BleuLlama/AmigaInputToUSB/Images/0703_Parts.png

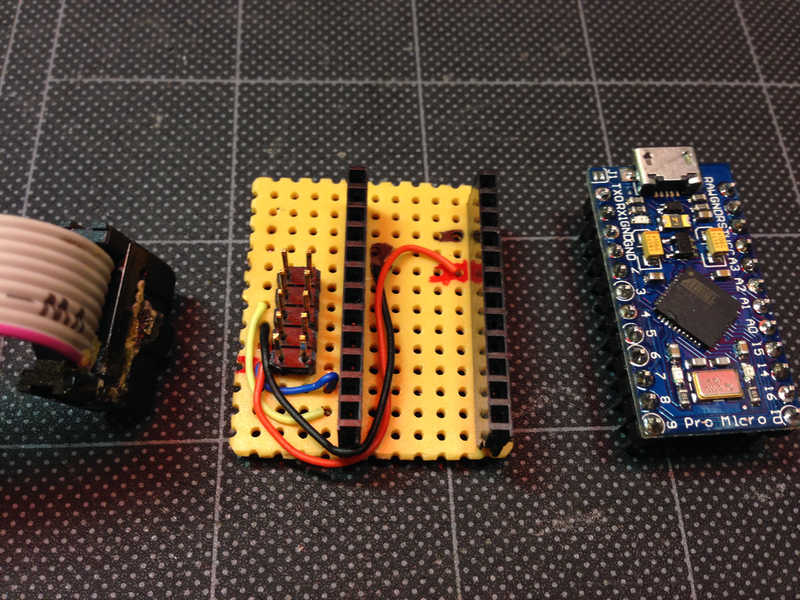
Images/0703_Parts.png
