BleuLlama/AmigaInputToUSB/Images/0703_AmigaMouse.png

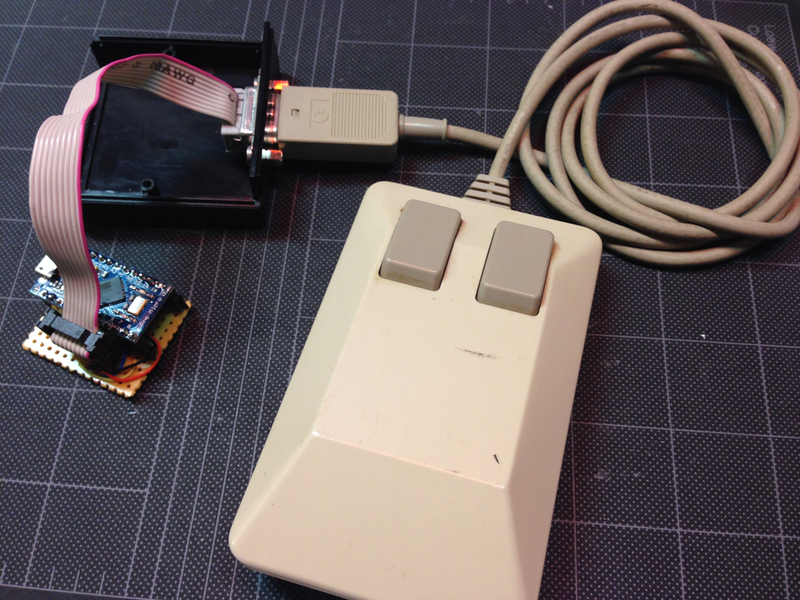
Images/0703_AmigaMouse.png
