BleuLlama/AmigaInputToUSB/Images/0703_Box.png

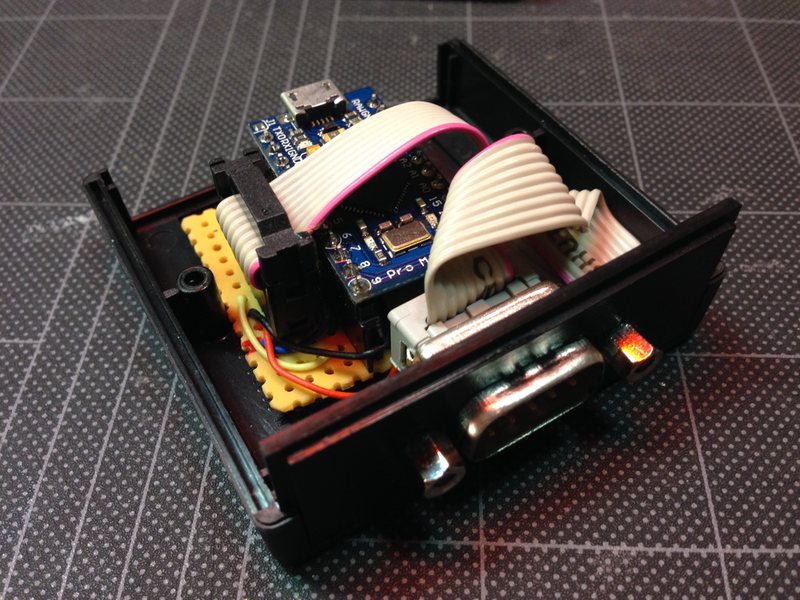
Images/0703_Box.png
