BleuLlama/AmigaInputToUSB/Images/0703_Joystick.png

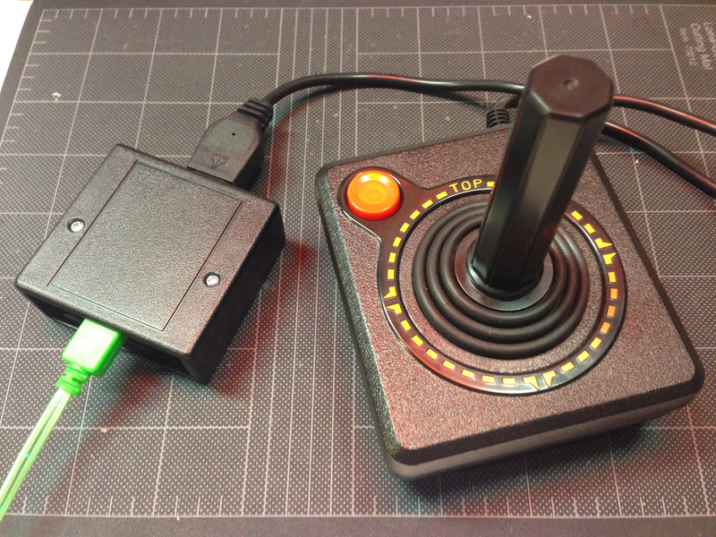
Images/0703_Joystick.png
