BleuLlama/AmigaInputToUSB/Images/Amiga_to_ST_converters.png

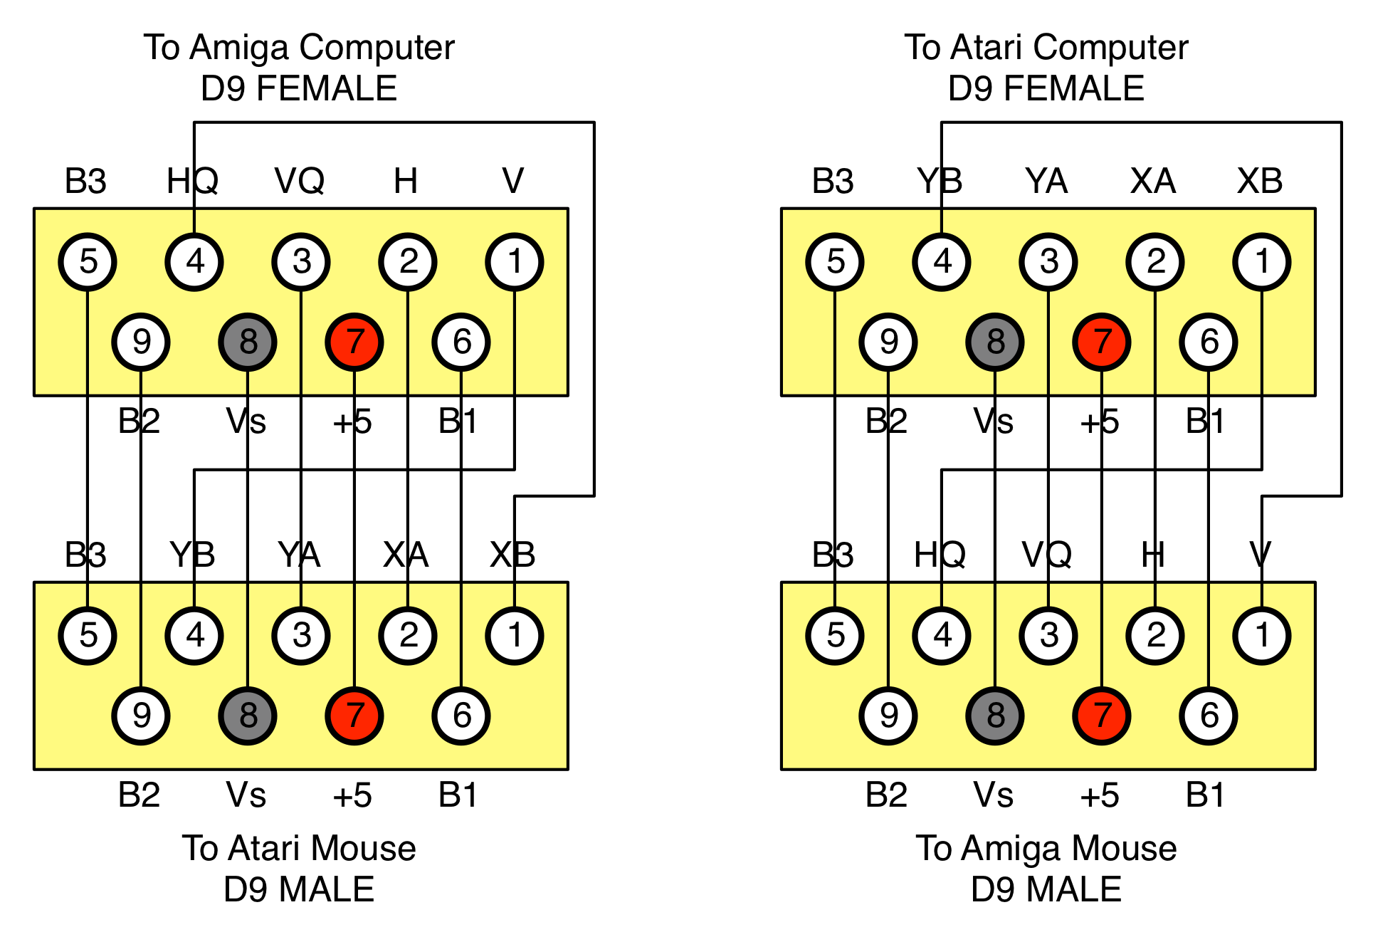
Images/Amiga_to_ST_converters.png
