BleuLlama/AmigaInputToUSB/Images/D9_pinouts.png

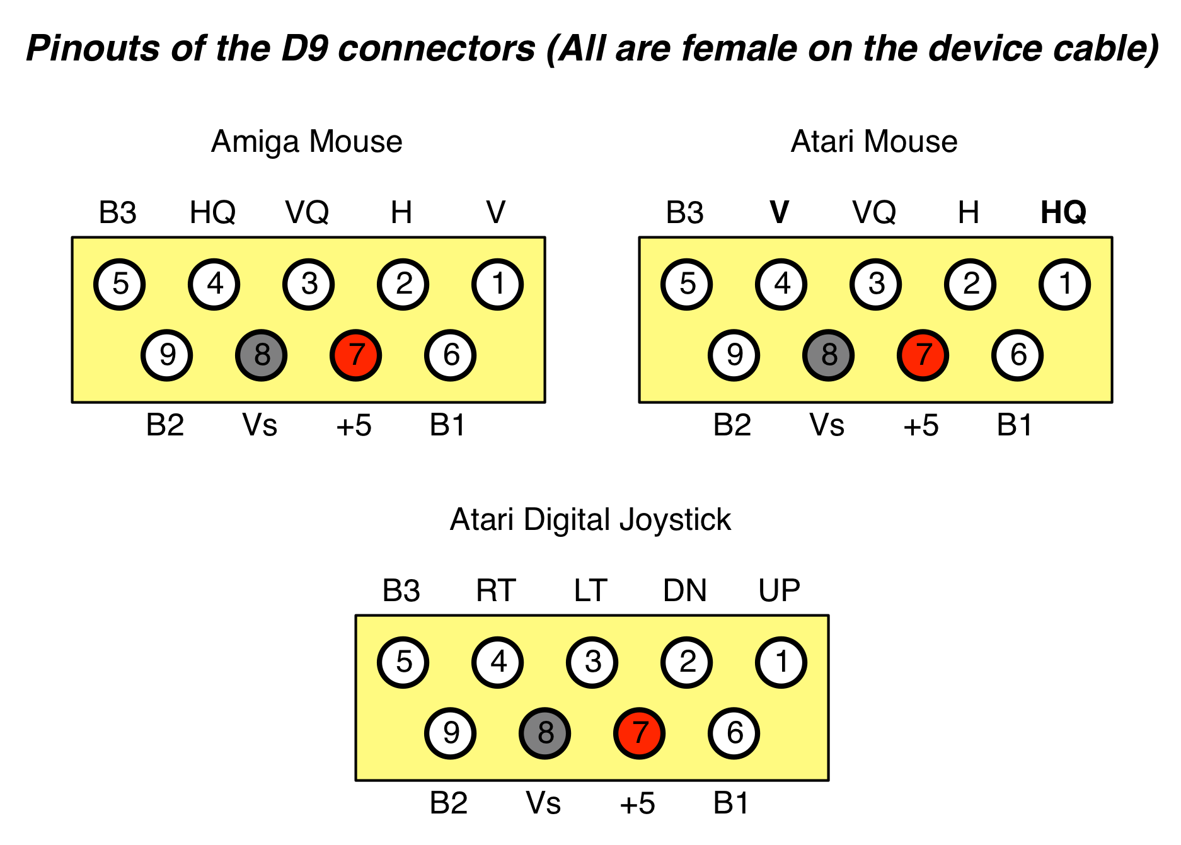
Images/D9_pinouts.png
