BleuLlama/AmigaInputToUSB/Images/Leonardo_Interface_v1.png

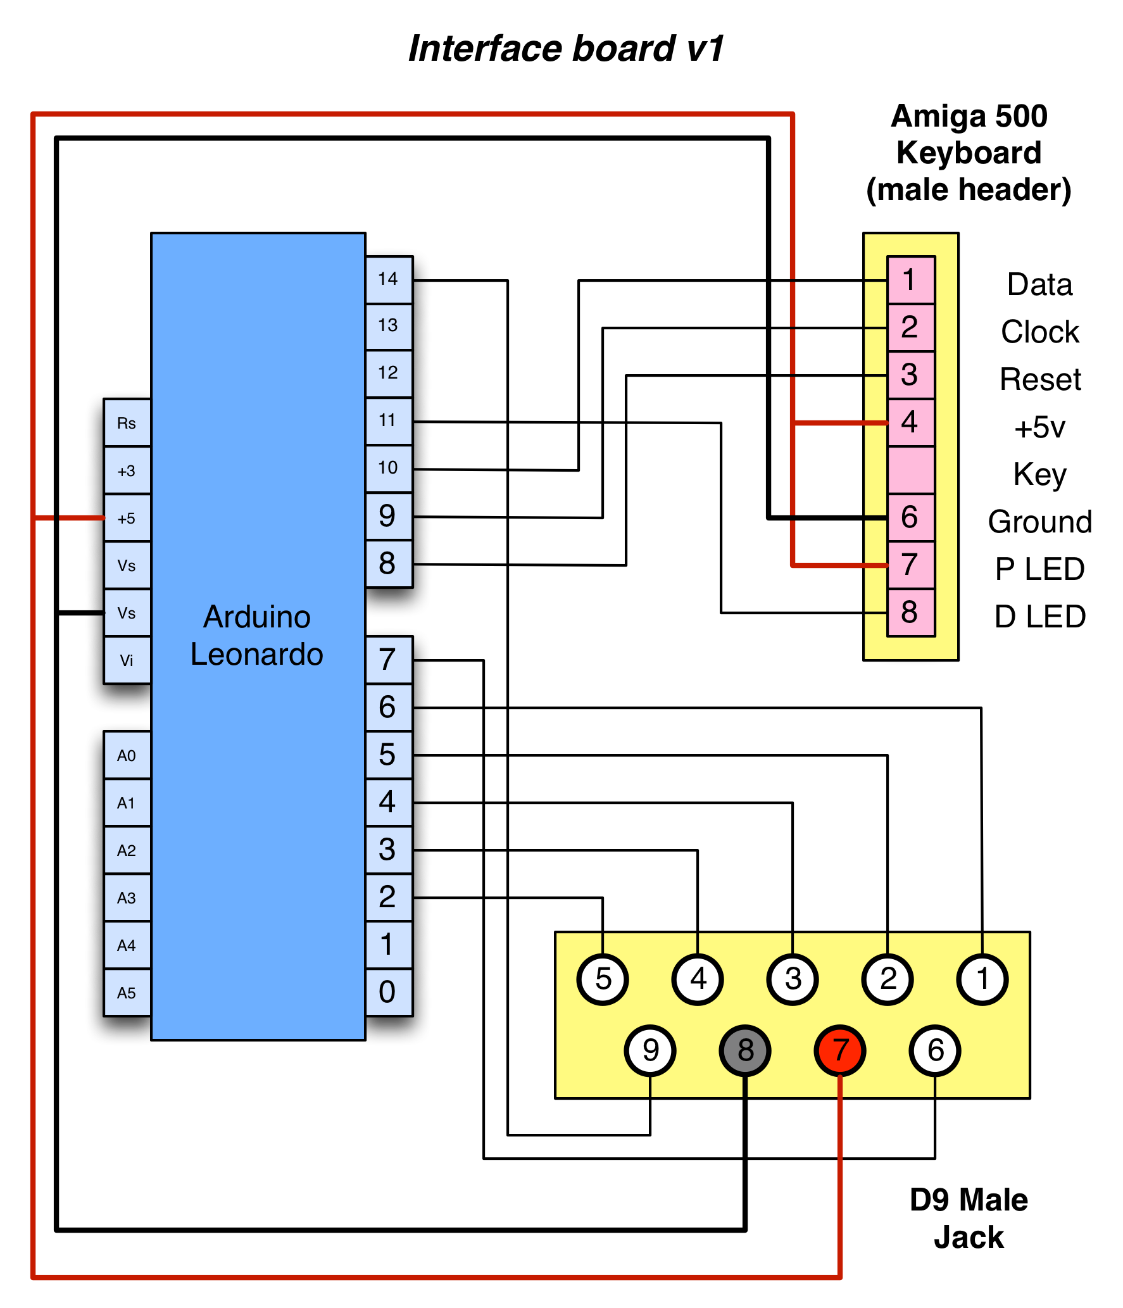
Images/Leonardo_Interface_v1.png
