BleuLlama/AmigaInputToUSB/Images/pinouts.png

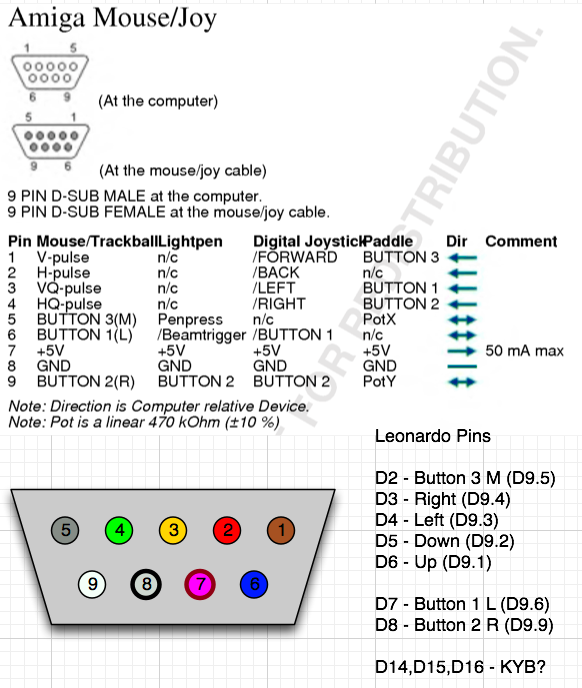
Images/pinouts.png
