BleuLlama/AmigaInputToUSB/Images/TI_to_Atari_converter.png

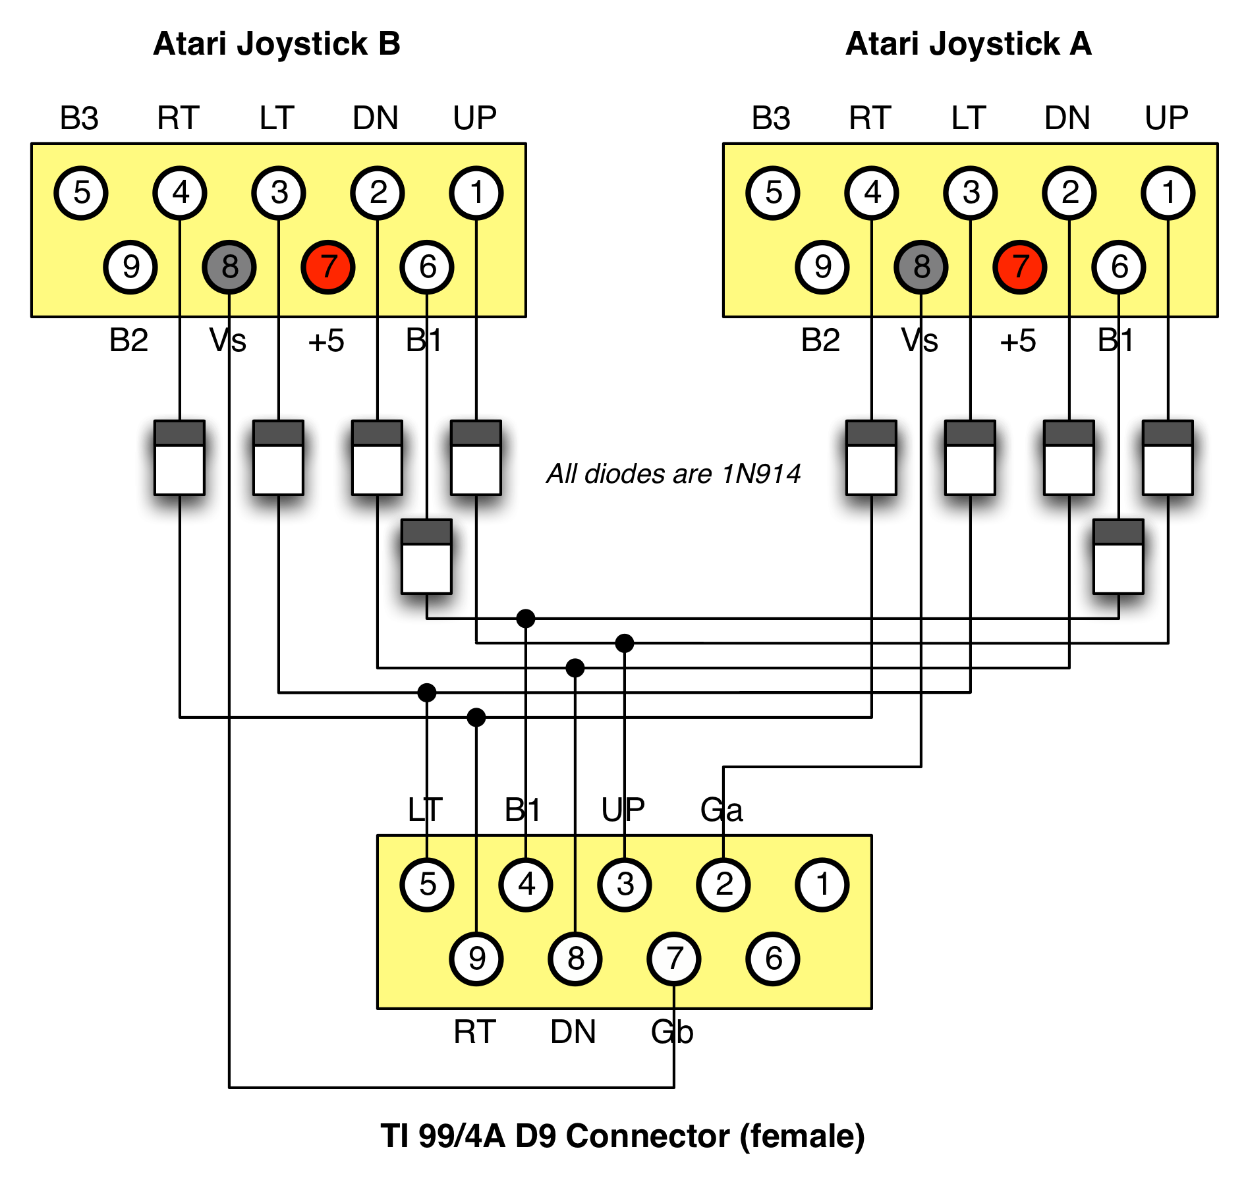
Images/TI_to_Atari_converter.png
