BleuLlama/AmigaInputToUSB/(commit log)

2015-07-15 Updated to include future work - Autodetect device type - Pushbuttons + 7 segment user input - Multiple ports
2015-07-20 Atari ST mouse support verified pin defines cleaned up
2015-07-21 Documenting the circuitry inside of a TI to dual Atari joystick adapter
